num-9i/stm32f411-env-monitor/Core/Src/main.c

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
/* Includes ------------------------------------------------------------------*/
#include "main.h"

/* USER CODE BEGIN Includes */


#include <stdio.h>
#include <string.h>

#include "aht20.h"
#include "bmp280.h"
#include "env_data.h"
#include "led_control.h"
#include "ssd1306.h"
#include "uart_cmd.h"
#include "modbus_rtu.h"
#include "fw_version.h"

/* USER CODE END Includes */

I2C_HandleTypeDef hi2c1;

TIM_HandleTypeDef htim2;

UART_HandleTypeDef huart1;
UART_HandleTypeDef huart2;

/* USER CODE BEGIN PV */
#define OLED_REPORT_INTERVAL_MS 10000U

uint32_t report_tick = 0U;



uint8_t cli_rx_byte = 0U; // UART2 CLI RX buffer
uint8_t modbus_rx_byte = 0U;

const LED_Config_t default_led_config =
{
    .enabled = 1,
    .mode = 0,
    .bright_pulse = 500,
    .blink_interval = 500,
    .breath_speed = 5,
    .timer_signal = 0,
    .timer_count = 1000
};

LED_Config_t g_led =
{
    .enabled = 1,
    .mode = 0,
    .bright_pulse = 500,
    .blink_interval = 500,
    .breath_speed = 5,
    .timer_signal = 0,
    .timer_count = 1000
};

UART_Handler g_cli_uart;
int auto_report_mode = 0;




uint8_t modbus_rx_buf[MODBUS_MIN_REQUEST_SIZE];
uint8_t modbus_tx_buf[MODBUS_MAX_TX_SIZE];

volatile uint16_t modbus_rx_idx = 0U;
volatile uint8_t modbus_request_ready = 0U;


volatile uint8_t g_temp_valid = 0U;
volatile uint8_t g_humi_valid = 0U;
volatile uint8_t g_press_valid = 0U;


/* USER CODE END PV */

void SystemClock_Config(void);
static void MX_GPIO_Init(void);
static void MX_TIM2_Init(void);
static void MX_I2C1_Init(void);
static void MX_USART1_UART_Init(void);
static void MX_USART2_UART_Init(void);
/* USER CODE BEGIN 0 */

/* Disable printf() output to avoid contaminating the Modbus line. */
int _write(int file, char *ptr, int len)
{
    (void)file;
    HAL_UART_Transmit(&huart2, (uint8_t *)ptr, len, 100);
    return len;
}

void HAL_UART_RxCpltCallback(UART_HandleTypeDef *huart)
{
    if (huart->Instance == USART1)
    {
        if (modbus_request_ready == 0U)
     {

        	if (modbus_rx_idx < MODBUS_MIN_REQUEST_SIZE)
        {

        		modbus_rx_buf[modbus_rx_idx++] = modbus_rx_byte;
        }


        	if (modbus_rx_idx >= MODBUS_MIN_REQUEST_SIZE)
        {

        		modbus_request_ready = 1U;

        		modbus_rx_idx = 0U;
        }
    }


        HAL_UART_Receive_IT(huart, &modbus_rx_byte, 1);

    }
    else if (huart->Instance == USART2)
    {
    	if((cli_rx_byte == '\r') || (cli_rx_byte == '\n'))
    	{
    		if(g_cli_uart.rx_idx > 0)
    		{
    			g_cli_uart.rx_buffer[g_cli_uart.rx_idx] = '\0';
    			g_cli_uart.flags.bits.is_ready = 1;
    			g_cli_uart.state = SYS_COMMAND_PENDING;
    		}
    	}
    	else
    	{
    		if(g_cli_uart.rx_idx < (sizeof(g_cli_uart.rx_buffer)-1))
    		{
    			g_cli_uart.rx_buffer[g_cli_uart.rx_idx++] = (char)cli_rx_byte;
    		}
    		else
    		{
    			memset(g_cli_uart.rx_buffer, 0, sizeof(g_cli_uart.rx_buffer));
    			g_cli_uart.rx_idx = 0;
    			g_cli_uart.flags.all_flags = 0;
    			g_cli_uart.state = SYS_ERROR;
    		}
    	}

    	HAL_UART_Receive_IT(&huart2, &cli_rx_byte, 1);


    }

}

/* USER CODE END 0 */

/**
  * @brief  The application entry point.
  * @retval int
  */
int main(void)
{

  /* MCU Configuration--------------------------------------------------------*/

  /* Reset of all peripherals, Initializes the Flash interface and the Systick. */
  HAL_Init();

  /* Configure the system clock */
  SystemClock_Config();

  /* Initialize all configured peripherals */
  MX_GPIO_Init();
  MX_TIM2_Init();
  MX_I2C1_Init();
  MX_USART1_UART_Init();
  MX_USART2_UART_Init();
  /* USER CODE BEGIN 2 */

  memset(&g_cli_uart, 0, sizeof(UART_Handler));

  memset(modbus_rx_buf, 0, sizeof(modbus_rx_buf));
  memset(modbus_tx_buf, 0, sizeof(modbus_tx_buf));
  modbus_rx_idx = 0U;
  modbus_request_ready = 0U;

  HAL_UART_Receive_IT(&huart1, &modbus_rx_byte, 1);
  HAL_UART_Receive_IT(&huart2, &cli_rx_byte, 1);

  UART_LOG("CLI ready on USART2.");

  HAL_TIM_Base_Start_IT(&htim2);
  HAL_TIM_PWM_Start(&htim2, TIM_CHANNEL_1);

  report_tick = HAL_GetTick();

  UART_LOG("Scanning I2C bus...");

  for (uint8_t i = 1; i < 128; i++)
  {
      HAL_StatusTypeDef result =
          HAL_I2C_IsDeviceReady(&hi2c1, (uint16_t)(i << 1), 3, 5);

      if (result == HAL_OK)
      {
          UART_LOG("Found device at: 0x%02X", i);
      }
  }

  UART_LOG("Scan Finished.");

  OLED_Init();
  OLED_Clear();
  OLED_SetCursor(0, 0);
  OLED_Printf("READY");

  BMP280_Init();
  AHT20_Init();

 UART_LOG("%s Boot", PROJECT_NAME);
 UART_LOG("FW Ver : %s", FW_VERSION);
 UART_LOG("Build  : %s %s",__DATE__,__TIME__);

  /* USER CODE END 2 */

  /* Infinite loop */
  /* USER CODE BEGIN WHILE */

    while (1)
    {
        uint32_t now = HAL_GetTick();

        BMP280_Task();
        AHT20_Task();

        BMP280_Get_Data(&g_temp, &g_press);
        AHT20_Get_Data(NULL, &g_humi);

        BMP280_Get_RawAdc(&g_raw_adc_T, &g_raw_adc_P);
        g_raw_humi = AHT20_Get_RawHumi();

        LED_Auto_Control(g_humi);



        if ((now - report_tick) >= OLED_REPORT_INTERVAL_MS)
        {
            char buf[32];

            report_tick = now;

            OLED_Clear();

            Env_Fixed_t t = Env_Get_Temp_Fixed();
            Env_Fixed_t h = Env_Get_Humi_Fixed();
            int32_t p = Env_Get_Press_Fixed();

            snprintf(buf, sizeof(buf), "TEMP: %s%d.%02d C", t.sign_str, t.whole, t.frac);
            OLED_SetCursor(0, 0);
            OLED_Printf(buf);

            snprintf(buf, sizeof(buf), "HUMI: %d.%02d %%", h.whole, h.frac);
            OLED_SetCursor(2, 0);
            OLED_Printf(buf);

            snprintf(buf, sizeof(buf), "PRES: %ld HPA", (long)p);
            OLED_SetCursor(4, 0);
            OLED_Printf(buf);

            if (auto_report_mode)
            {
                UART_LOG("[Auto Report] T:%s%d.%02dC, H:%d.%02d%%, P:%ldhPa",
                         t.sign_str, t.whole, t.frac,
                         h.whole, h.frac,
                         (long)p);
            }

        }


        if (modbus_request_ready)
        {
            Modbus_Request_t request;
            Modbus_Status_t status;
            uint16_t tx_len = 0U;

            status = Modbus_ParseRequest(modbus_rx_buf,
                                         MODBUS_MIN_REQUEST_SIZE,
                                         &request);

            if (status == MODBUS_OK)
            {
                tx_len = Modbus_BuildReadHoldingResponse(&request,
                                                         modbus_tx_buf,
                                                         sizeof(modbus_tx_buf));
            }
            else if (status == MODBUS_ERR_FUNC)
            {
                tx_len = Modbus_BuildExceptionResponse(MODBUS_SLAVE_ADDR,
                                                       MODBUS_FUNC_READ_HOLDING_REGS,
                                                       MODBUS_EXCEPTION_ILLEGAL_FUNC,
                                                       modbus_tx_buf,
                                                       sizeof(modbus_tx_buf));
            }
            else if (status == MODBUS_ERR_ADDR)
            {
                tx_len = Modbus_BuildExceptionResponse(MODBUS_SLAVE_ADDR,
                                                       MODBUS_FUNC_READ_HOLDING_REGS,
                                                       MODBUS_EXCEPTION_ILLEGAL_ADDR,
                                                       modbus_tx_buf,
                                                       sizeof(modbus_tx_buf));
            }
            else if (status == MODBUS_ERR_VALUE)
            {
                tx_len = Modbus_BuildExceptionResponse(MODBUS_SLAVE_ADDR,
                                                       MODBUS_FUNC_READ_HOLDING_REGS,
                                                       MODBUS_EXCEPTION_ILLEGAL_VALUE,
                                                       modbus_tx_buf,
                                                       sizeof(modbus_tx_buf));
            }
            else
            {
                tx_len = 0U;
            }

            if (tx_len > 0U)
            {
                HAL_UART_Transmit(&huart1, modbus_tx_buf, tx_len, 100);
            }

            memset(modbus_rx_buf, 0, sizeof(modbus_rx_buf));
            modbus_request_ready = 0U;
        }

        UART_ProcessCommand(&g_cli_uart);

    /* USER CODE END WHILE */

    /* USER CODE BEGIN 3 */
    }
  /* USER CODE END 3 */
}

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
/* USER CODE BEGIN 4 */
void HAL_TIM_PeriodElapsedCallback(TIM_HandleTypeDef *htim)
{
    if (htim->Instance == TIM2)
    {
        LED_Update_Handler();
    }
}
/* USER CODE END 4 */
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
