num-9i/stm32f411-env-monitor/Core/Inc/fw_version.h

/*
 * fw_version.h
 *
 *
 *
 */

#ifndef INC_FW_VERSION_H_
#define INC_FW_VERSION_H_


#define PROJECT_NAME    "ENV_MONITOR"
#define FW_VERSION      "1.0.0"
#define HW_VERSION      "NUCLEO-F411RE"


#endif /* INC_FW_VERSION_H_ */
