num-9i/stm32f411-env-monitor/(commit log)

2026-03-13 Revise Current Limitations and Future Work sections
    Updated the Current Limitations and Future Work sections in README.md to reflect changes in English and Korean.
2026-03-16 Fix valid flag handling in Modbus status register
    [aht20.c, bmp280.c, main.c, main.h, modbus_rtu.c]
2026-04-07 seperate CLI and Modbus UART paths and add SNAP diagostic command
    [Curriculum.ioc, main.c, uart_cmd.c]
2026-04-07 Update README with concurrent verification and sensor error analysis
    [aht20.c, aht20.h, bmp280.c, bmp280.h, main.c, uart_cmd.c]
